LEP-PEA-EPUSP/OpenSourcePowerElectronics-HW-TransformerBoard-2026/Others/20220222_125615.jpg

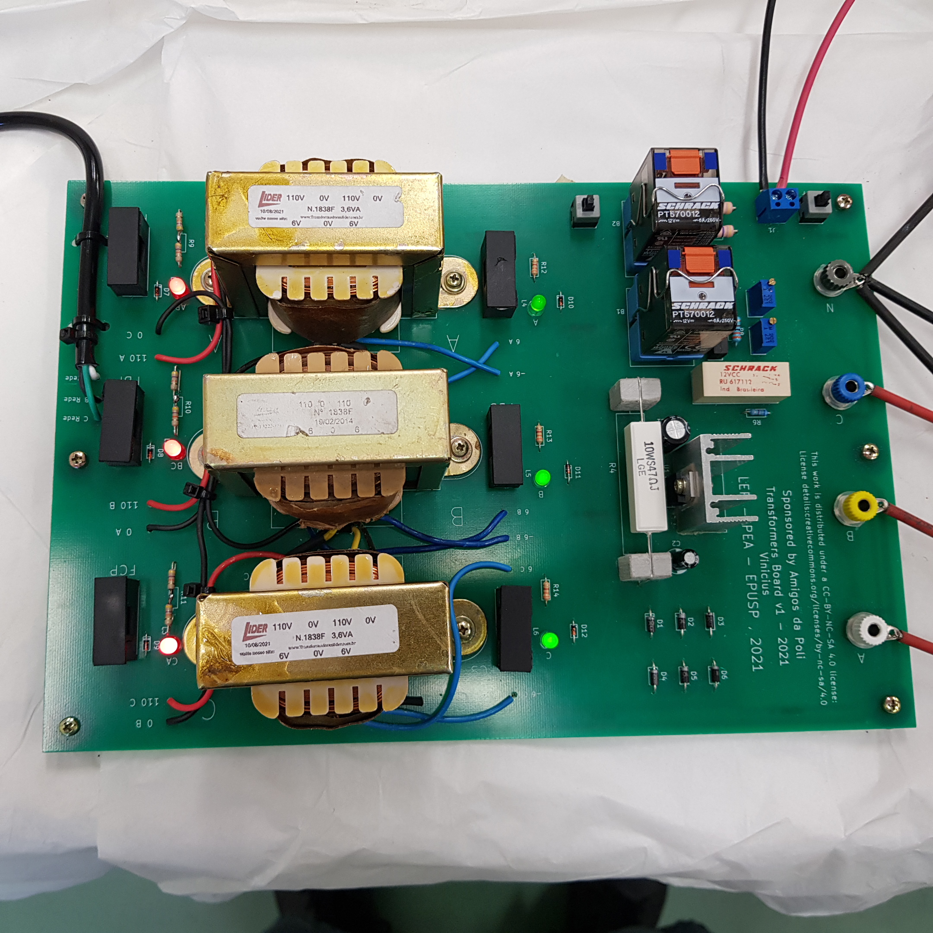
Others/20220222_125615.jpg
