LEP-PEA-EPUSP/OpenSourcePowerElectronics-HW-TransformerBoard-2026/README.md

# OpenSourcePowerElectronics-HW-TransformerBoard-2026

This repository contains the manuals, schematics and layout needed to build and test the transformer board.
