LEP-PEA-EPUSP/OpenSourcePowerElectronics-HW-TransformerBoard-2026/Schematics and Layout/PT570012.PNG

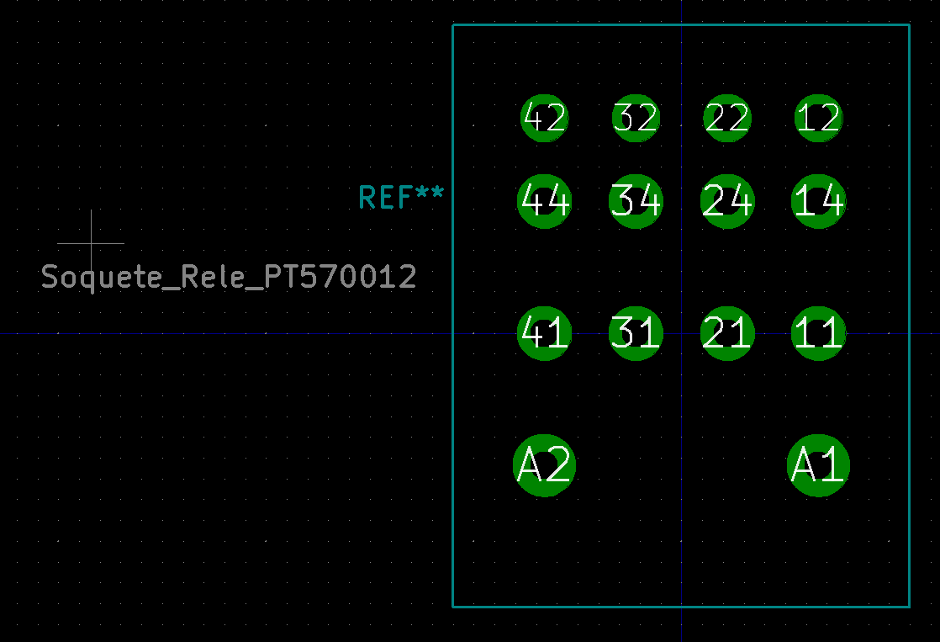
Schematics and Layout/PT570012.PNG
