LEP-PEA-EPUSP/OpenSourcePowerElectronics-HW-TransformerBoard-2026/Schematics and Layout/RU617112.PNG

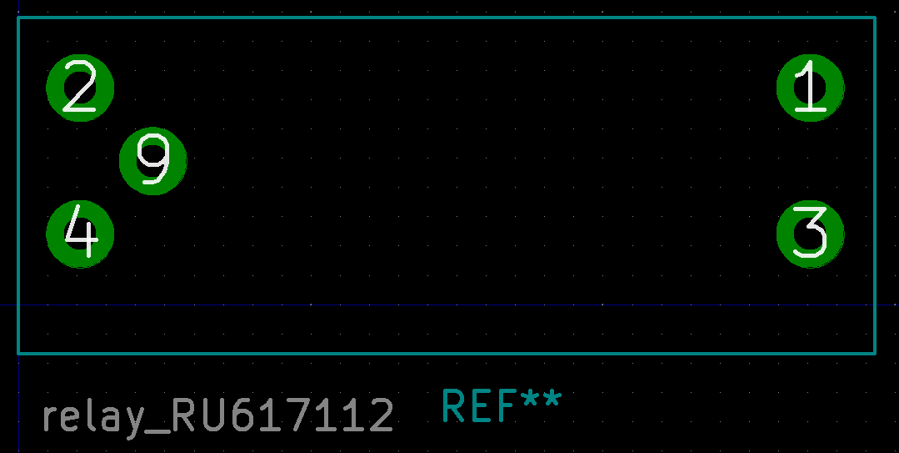
Schematics and Layout/RU617112.PNG
