LEP-PEA-EPUSP/OpenSourcePowerElectronics-HW-TransformerBoard-2026/Schematics and Layout/SH1NAC2.PNG

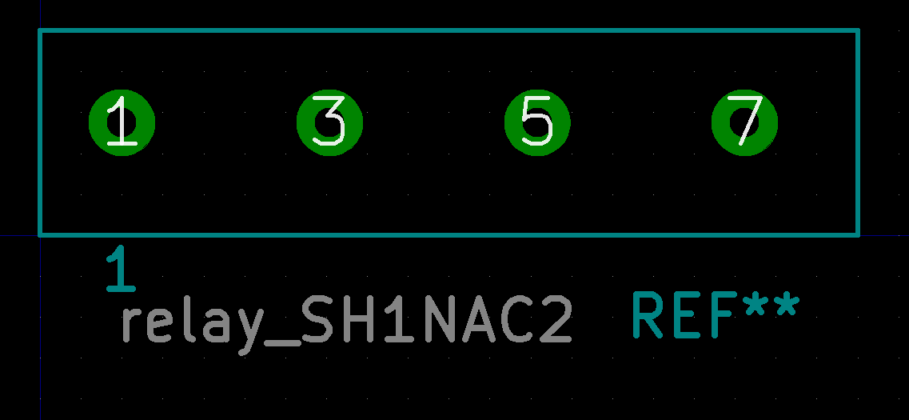
Schematics and Layout/SH1NAC2.PNG
