LEP-PEA-EPUSP/OpenSourcePowerElectronics-HW-TransformerBoard-2026/Schematics and Layout/camadas.pdf

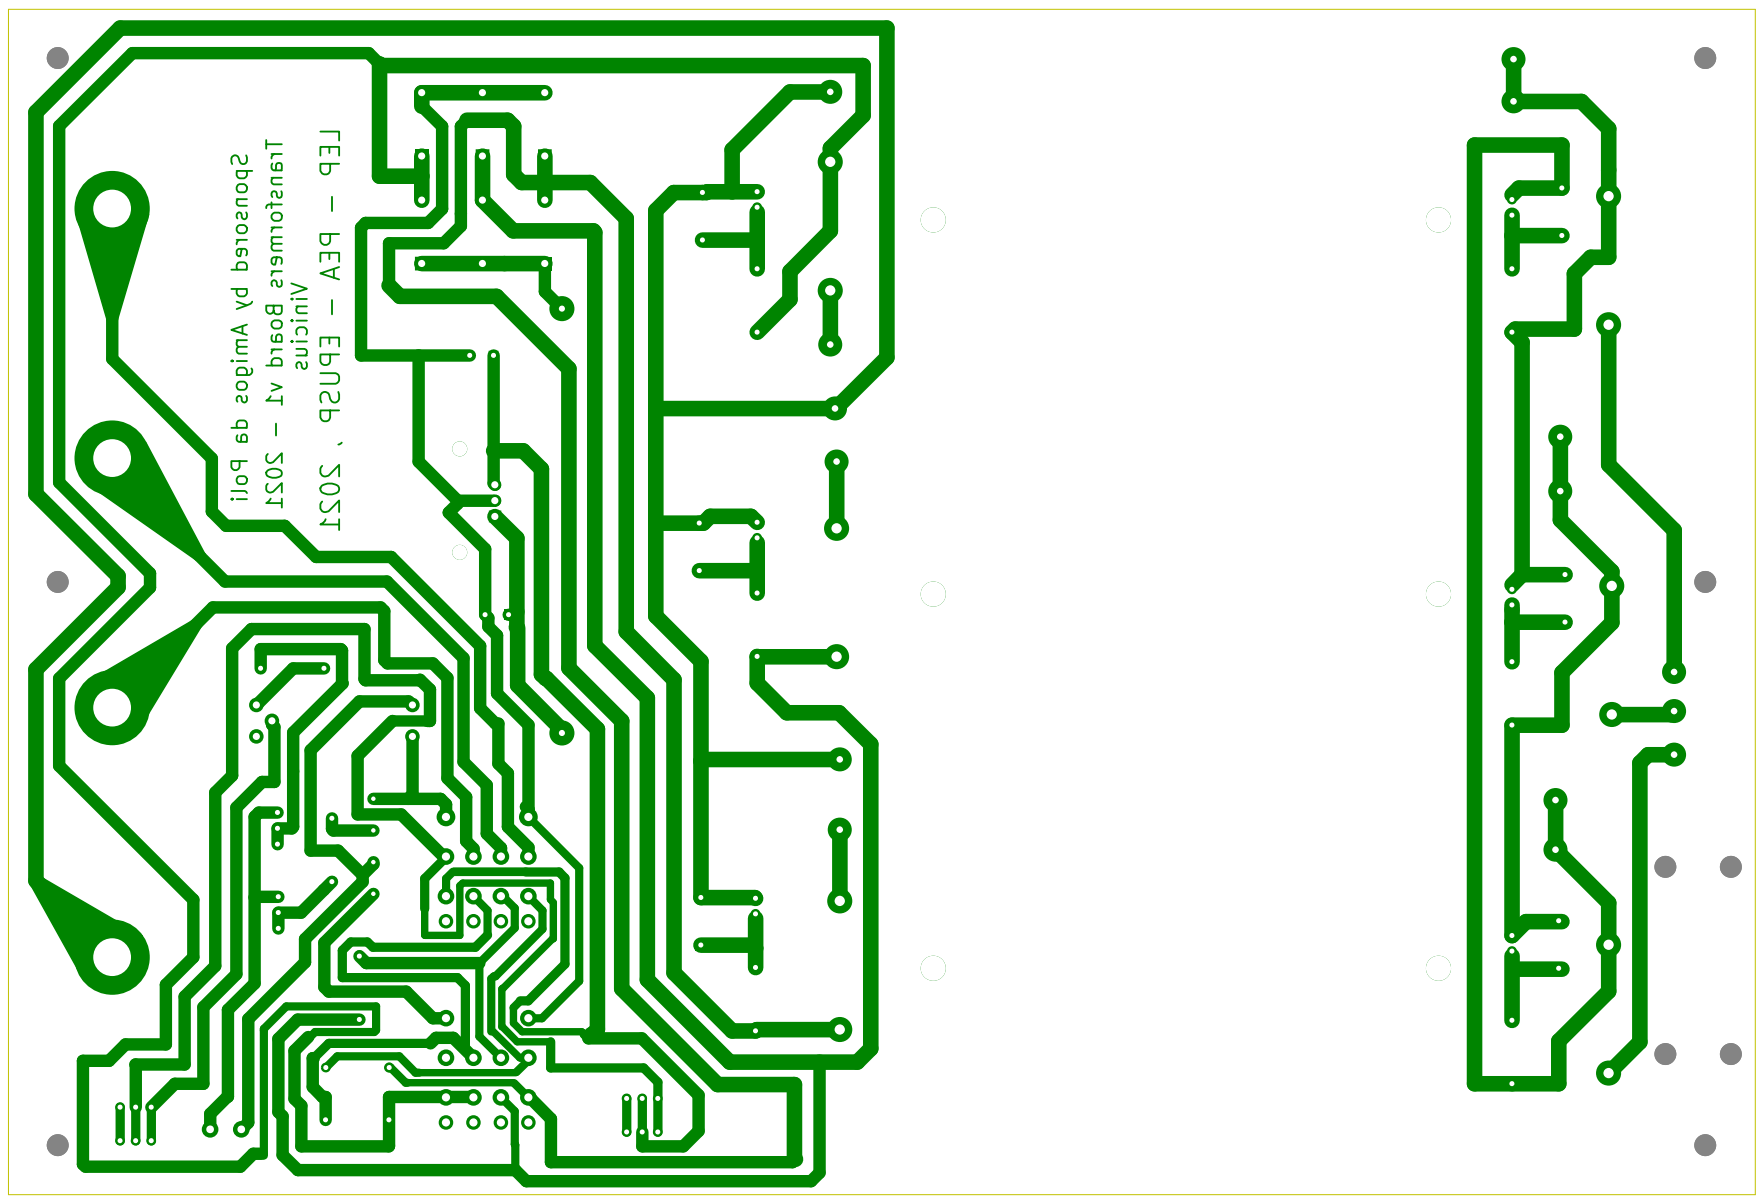
[picture p11: page 1]

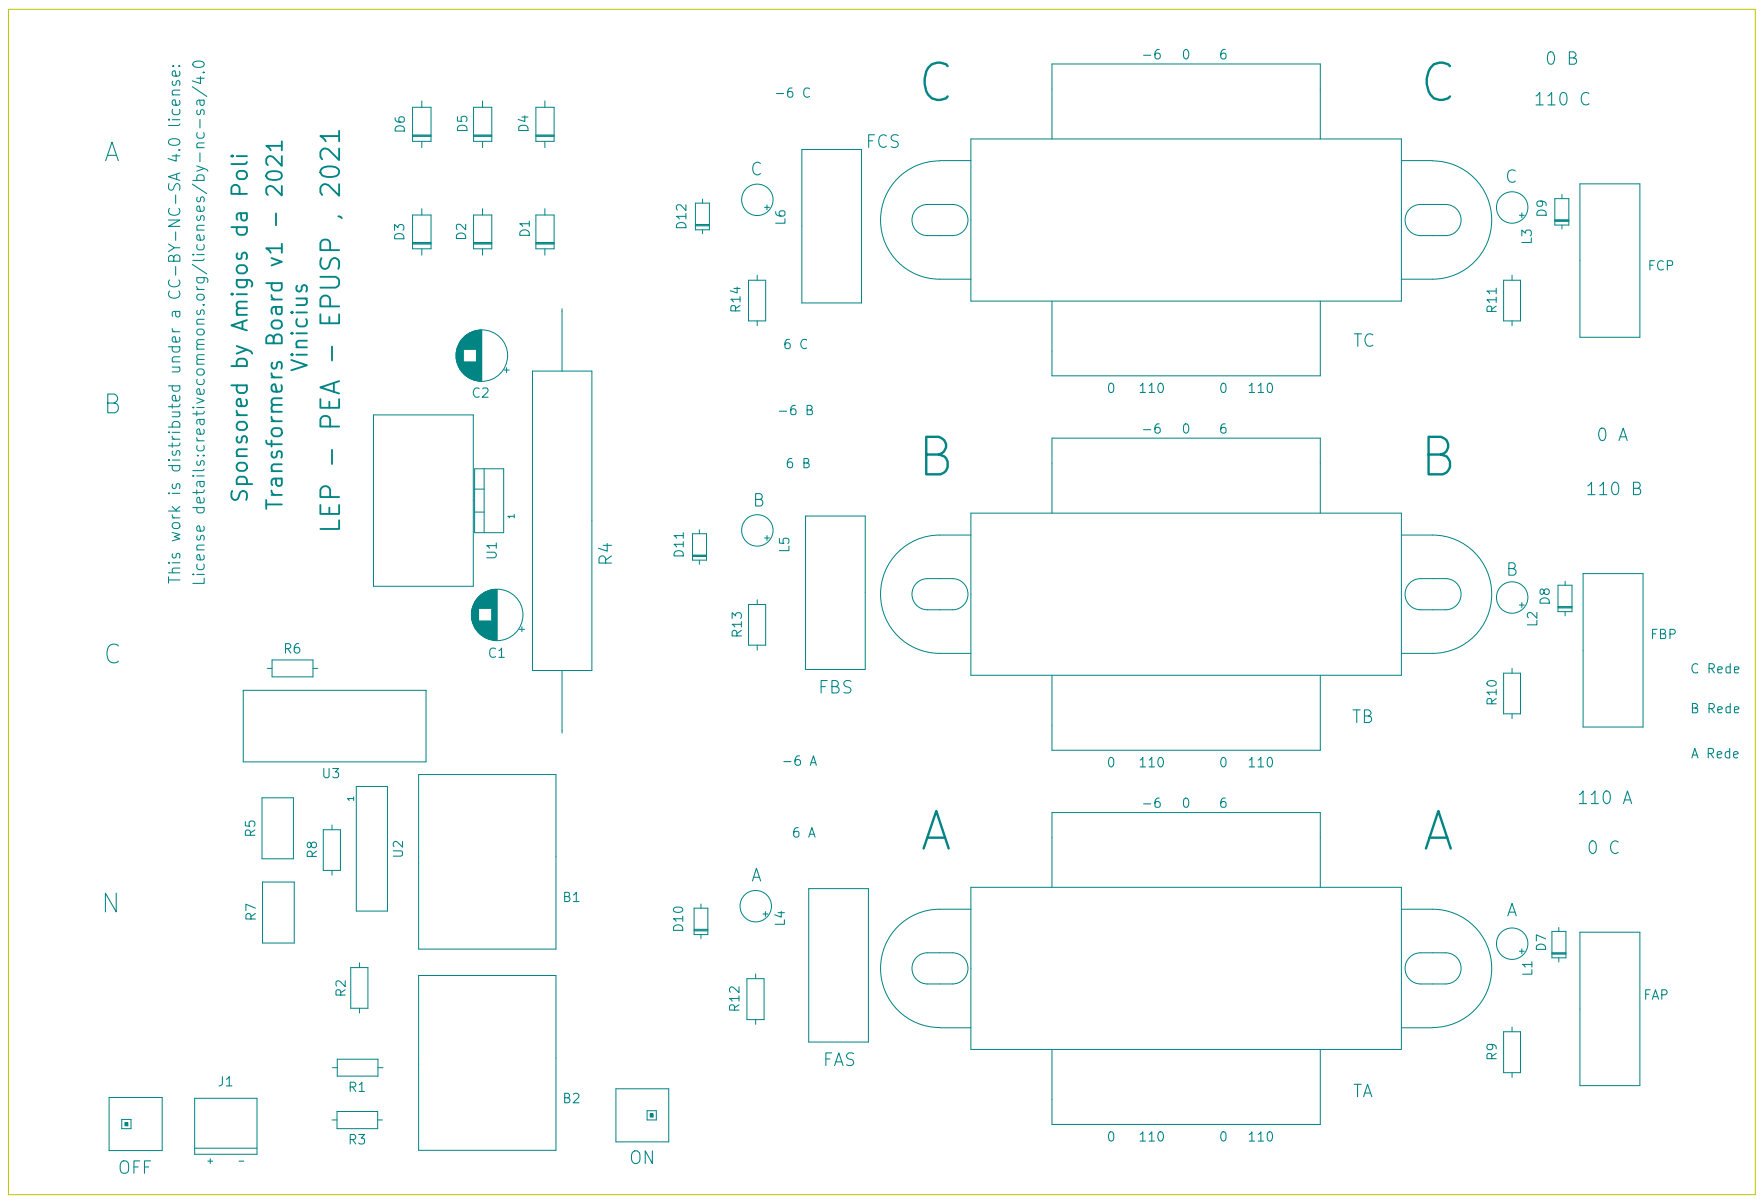
[picture p12: page 2]

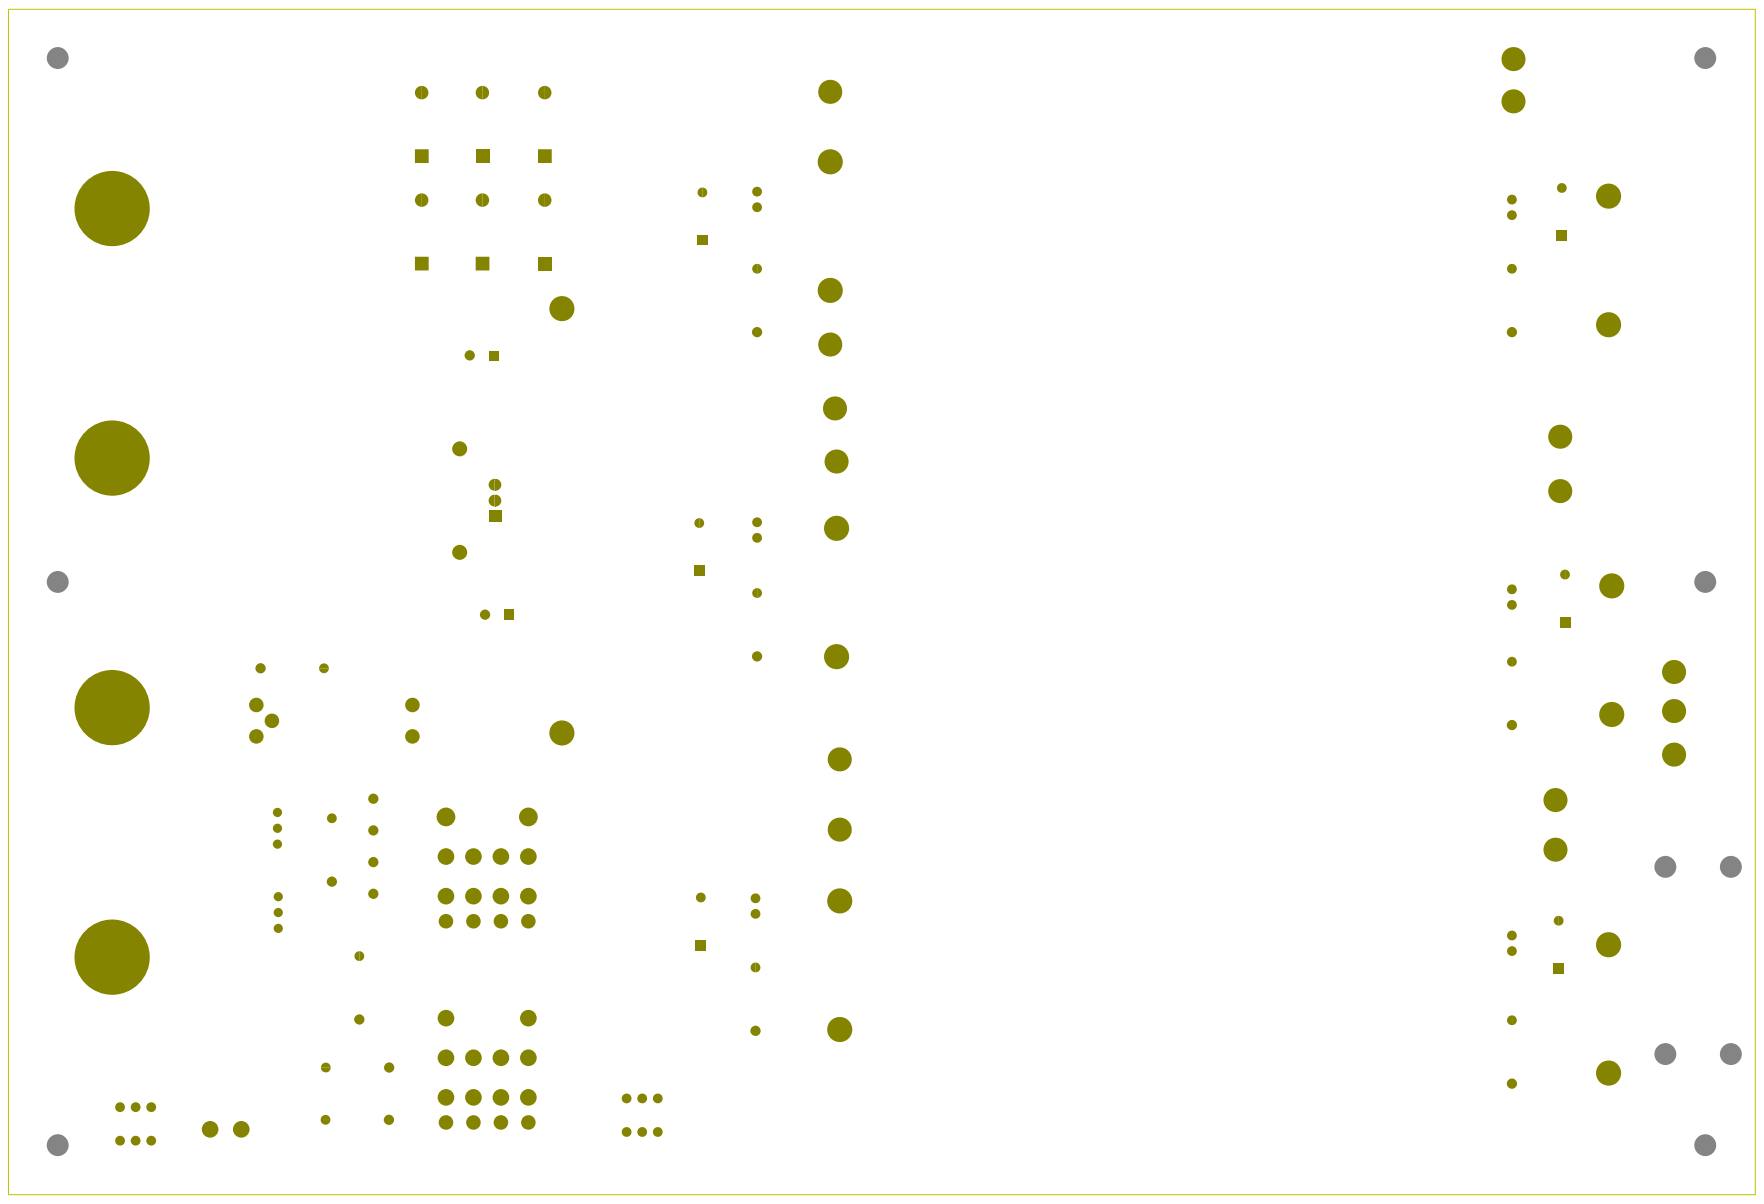
[picture p13: page 3]
