LEP-PEA-EPUSP/OpenSourcePowerElectronics-HW-TransformerBoard-2026/Schematics and Layout/camadas_Trafo.pdf

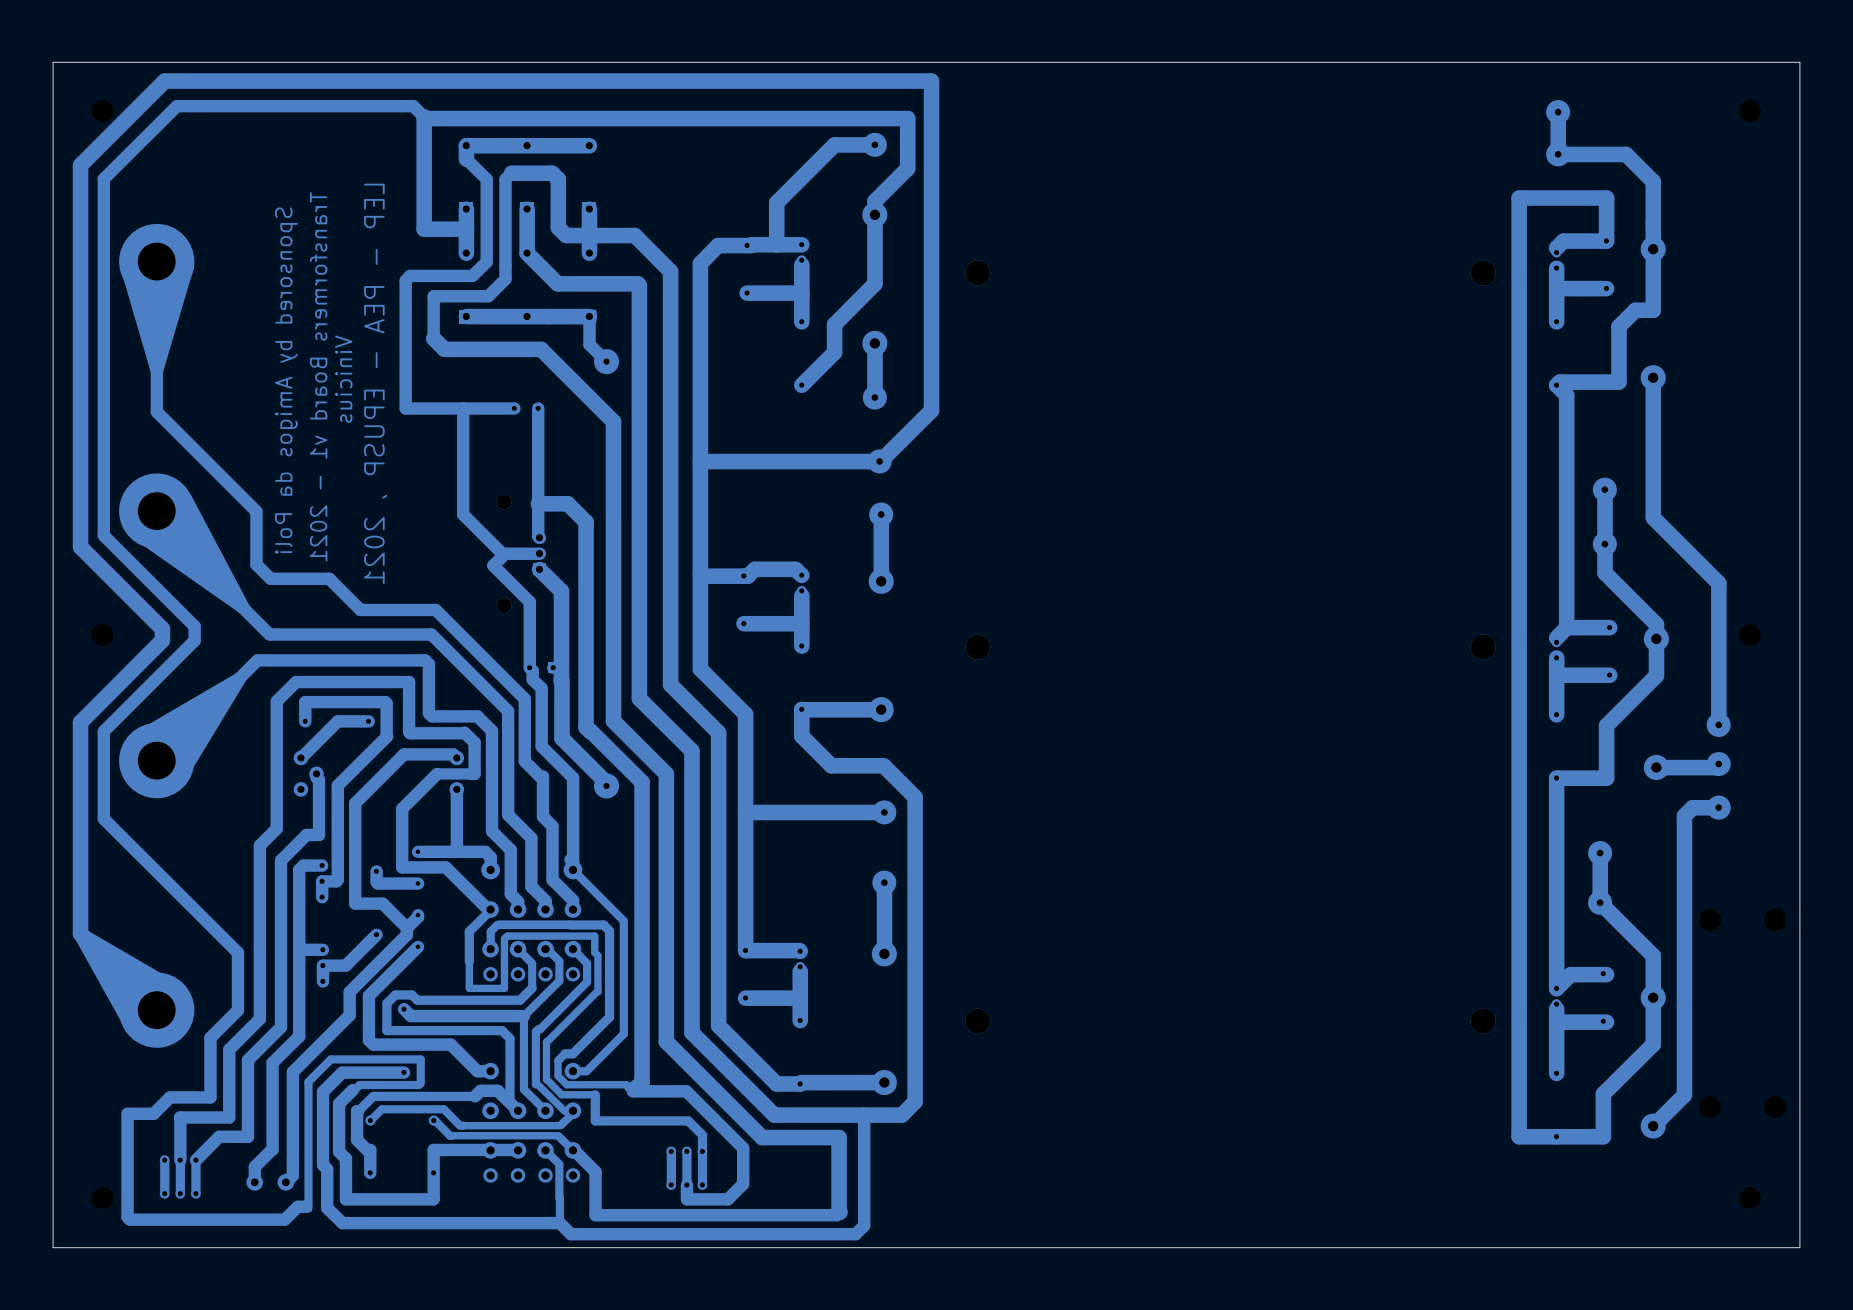
[picture p14: page 1]

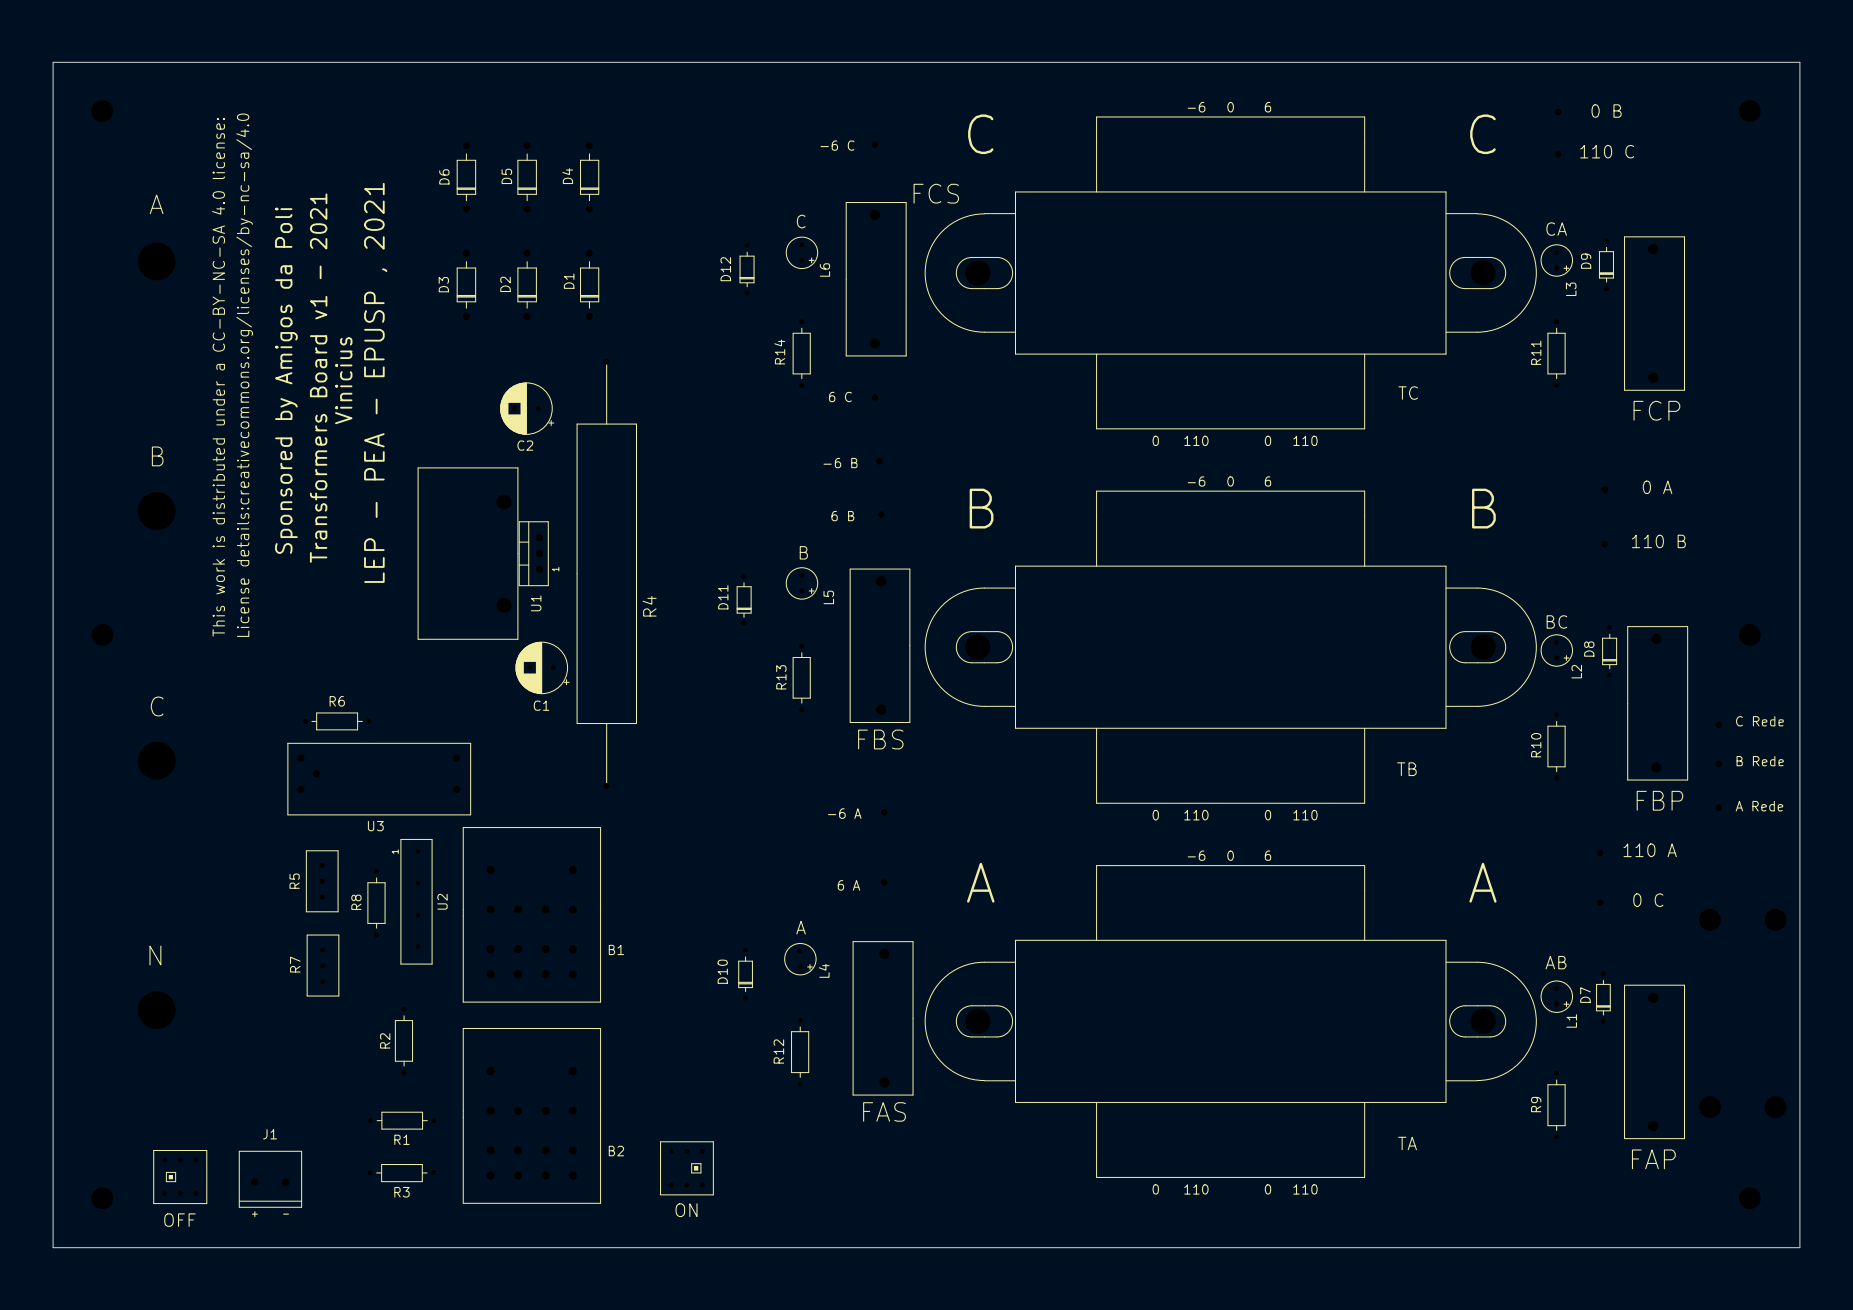
[picture p15: page 2]

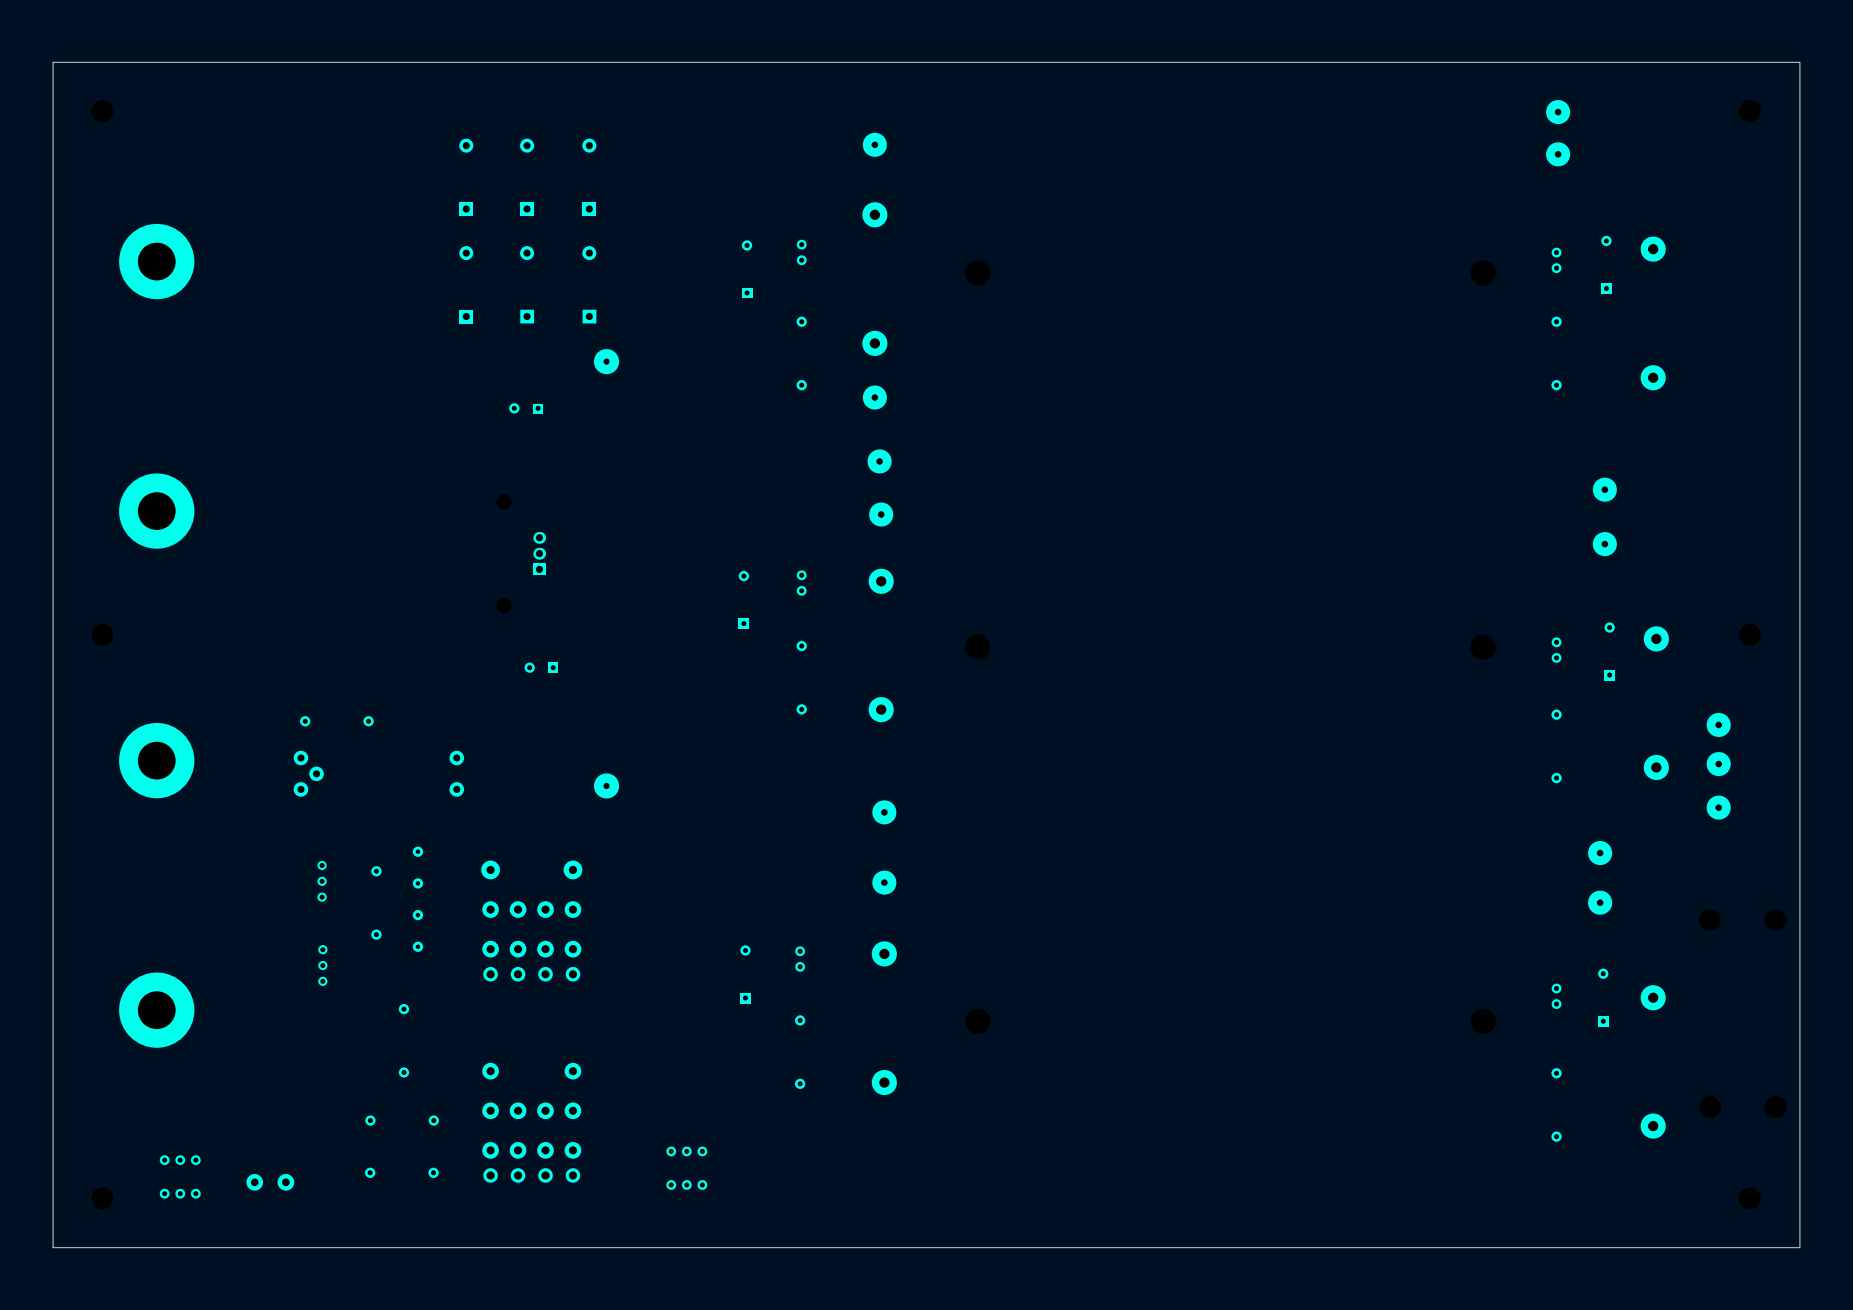
[picture p16: page 3]

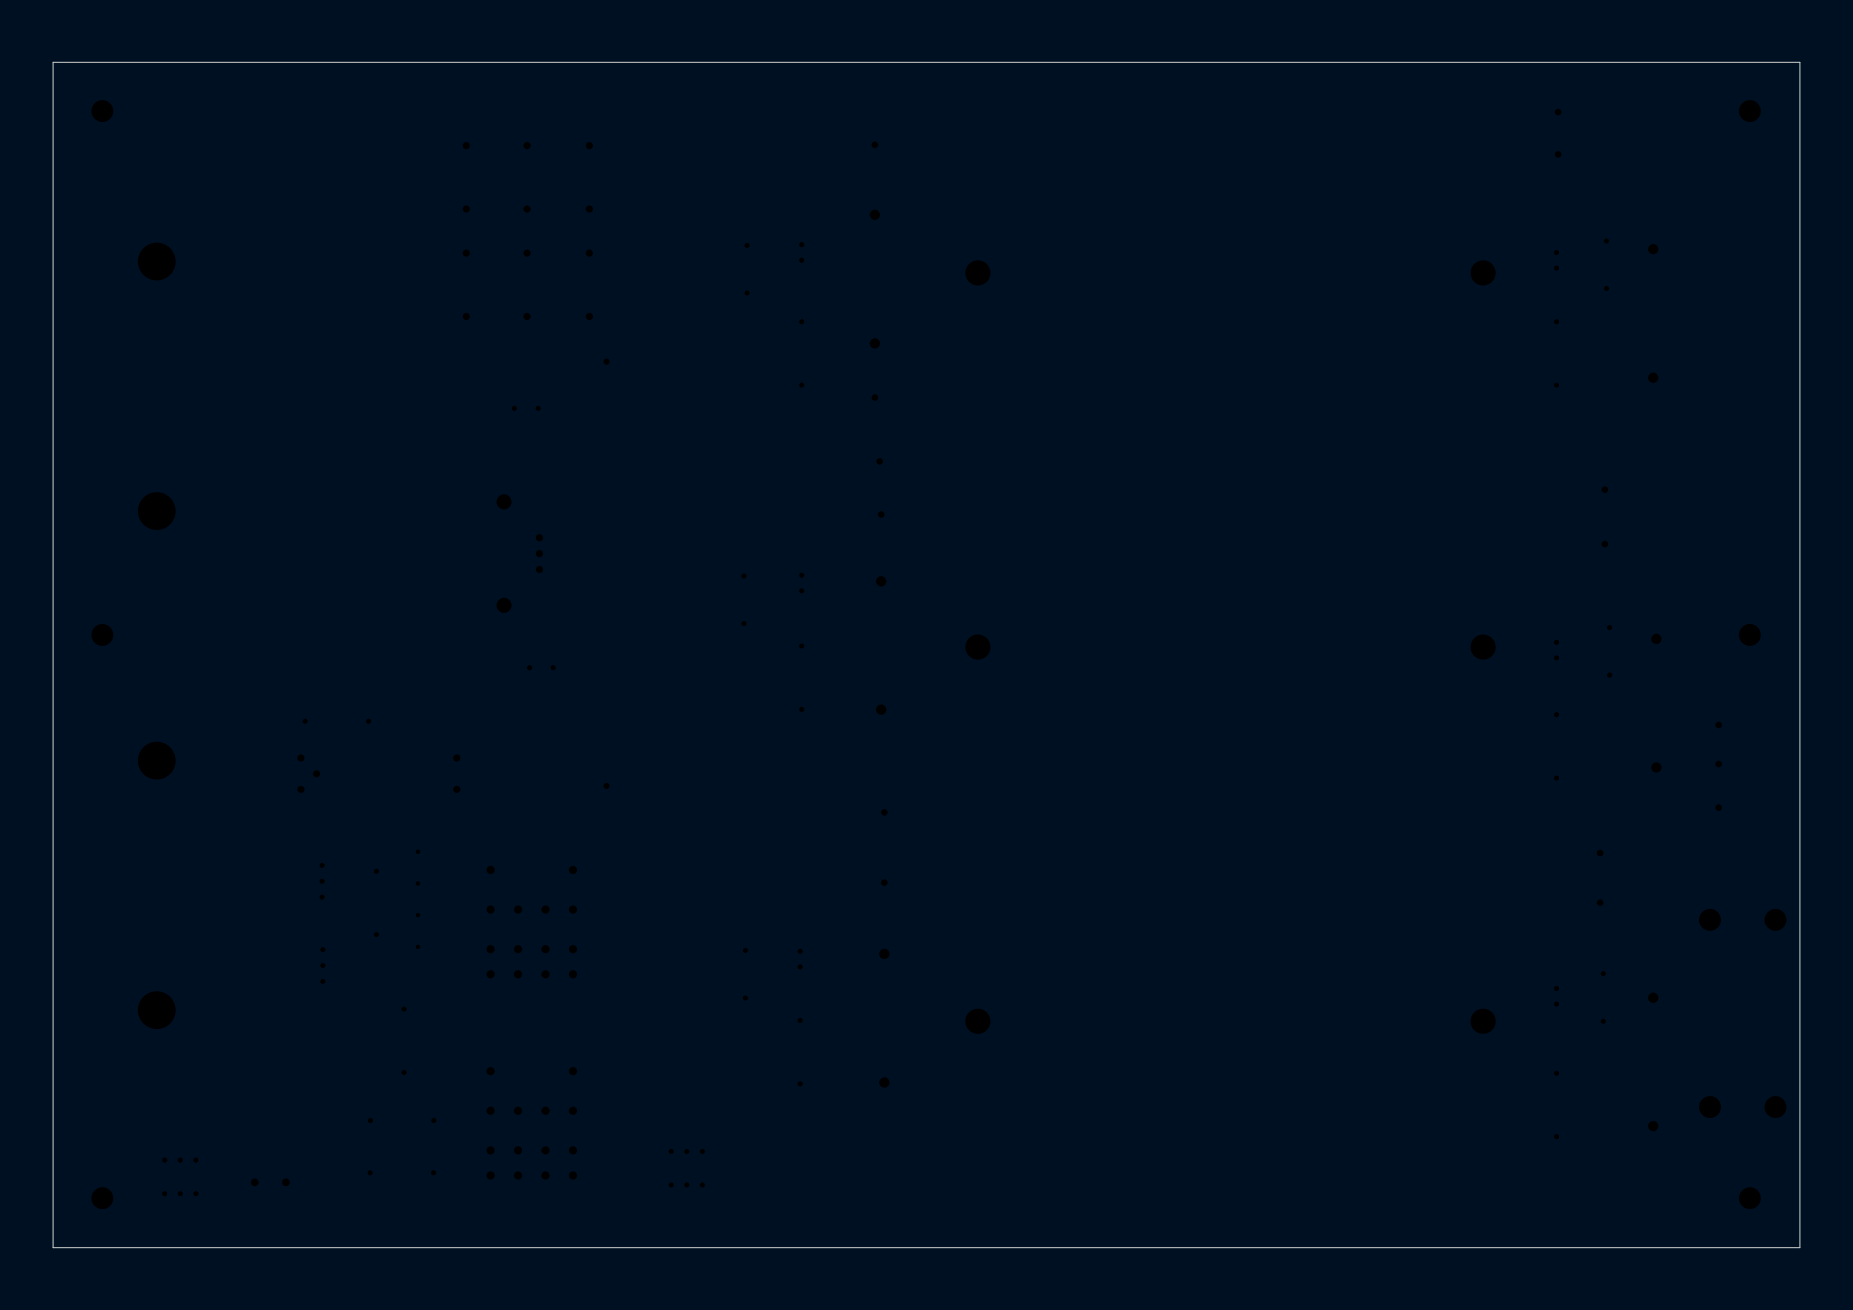
[picture p17: page 4]
