LEP-PEA-EPUSP/OpenSourcePowerElectronics-HW-TransformerBoard-2026/Schematics and Layout/layout_Trafo.pdf

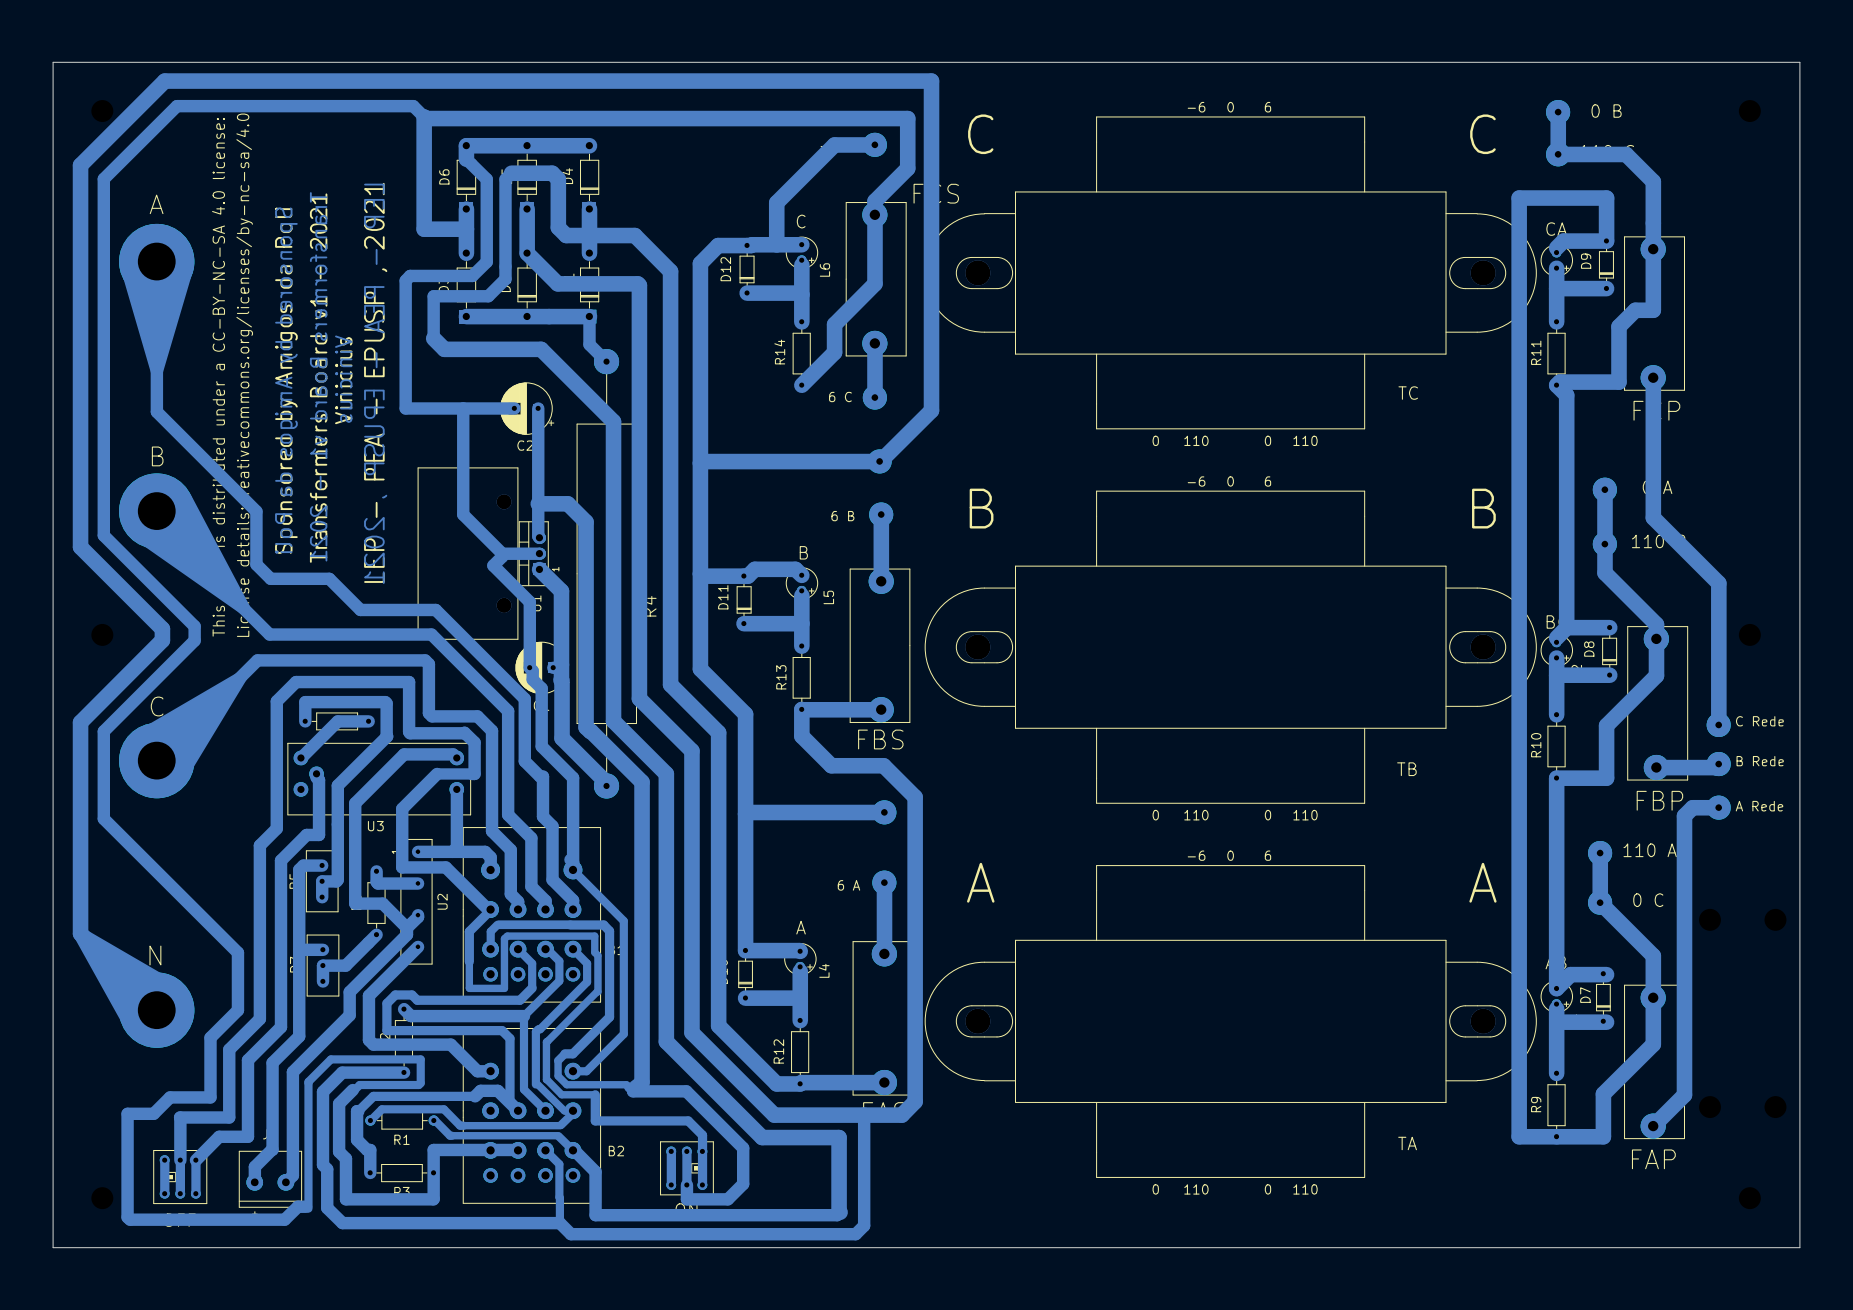
[picture p20: page 1]
