LEP-PEA-EPUSP/OpenSourcePowerElectronics-HW-TransformerBoard-2026/Schematics and Layout/Placa de Trafos.kicad_pcb

## KiCad design Schematics and Layout/Placa de Trafos.kicad_pcb (2026-06-19)

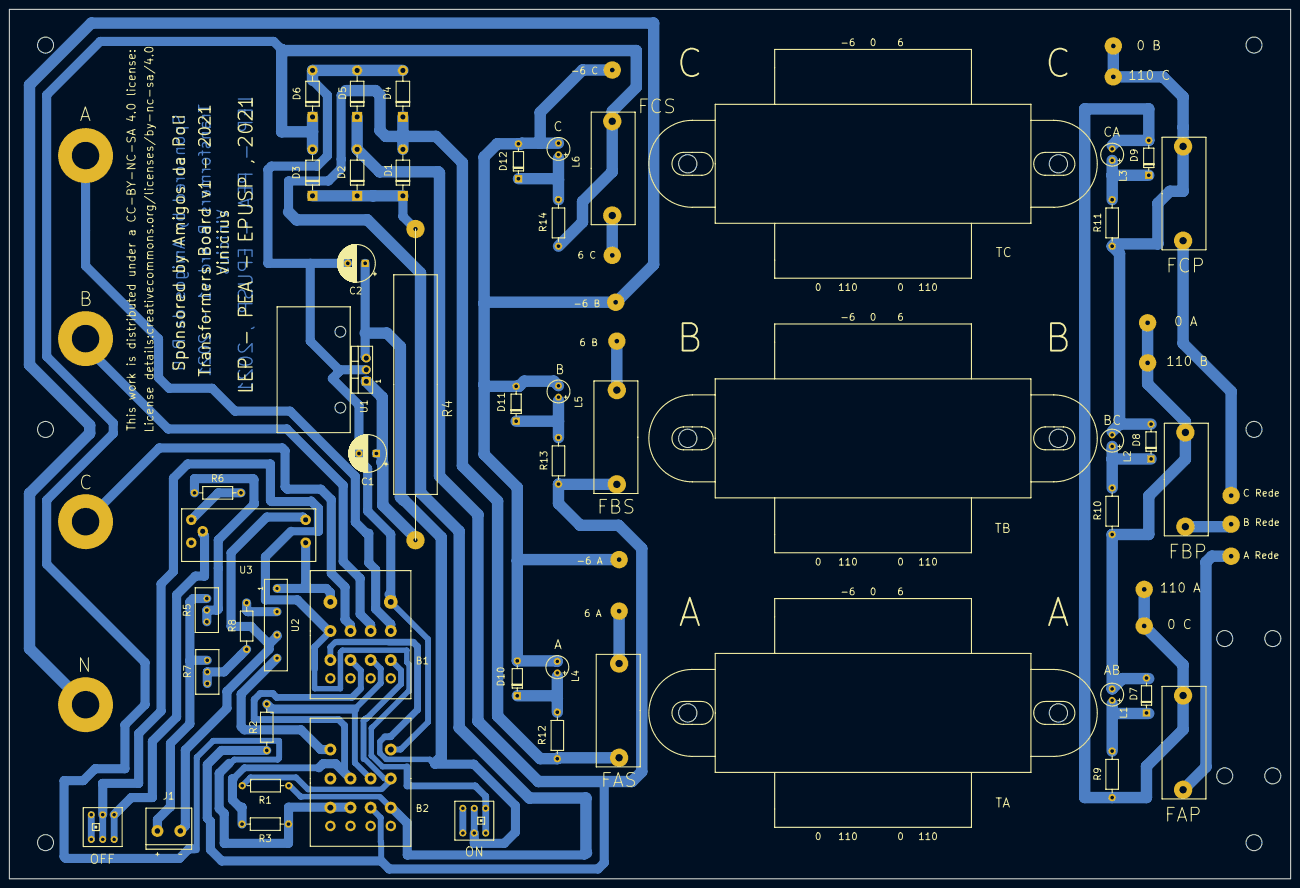
[picture p21: board Placa de Trafos.kicad_pcb from above]

Board: 2 copper layers, 280.0 x 190.0 mm, 80 parts (0 on the bottom side), 39 nets.

Parts:
0_A1, 0_B1, 0_C1, 6_A1, 6_B1, 6_C1, 110_A1, 110_B1, 110_C1: Conn_01x01_Female; cabo_PP
-6_A1, -6_B1, -6_C1: Conn_01x01_Female; cabo_PP
A1: Conn_01x01_Female; Borne
A_rede1: Conn_01x01_Female; cabo_PP
B1, B2: rele_4C; Soquete_Rele_PT570012
B3: Conn_01x01_Female; Borne
B_rede1: Conn_01x01_Female; cabo_PP
C1: 100u/63V; CP_Radial_D8.0mm_P3.80mm
C2: 100u/25V; CP_Radial_D8.0mm_P3.80mm
C3: Conn_01x01_Female; Borne
C_rede1: Conn_01x01_Female; cabo_PP
D1, D2, D3, D4, D5, D6: 1N4001; D_DO-41_SOD81_P10.16mm_Horizontal
D7, D8, D9, D10, D11, D12: 1N4148; D_DO-35_SOD27_P7.62mm_Horizontal
FAP1: Fuse; Porta_Fuse
FAS1: Fuse; Porta_Fuse
FBP1: Fuse; Porta_Fuse
FBS1: Fuse; Porta_Fuse
FCP1: Fuse; Porta_Fuse
FCS1: Fuse; Porta_Fuse
Furo1, Furo2, Furo3, Furo4, Furo5, Furo6, Furo7, Furo8, Furo9, Furo10: Conn_01x01_Female; Furo-pé
J1: Conn_01x02_Female; Conector_parafuso
L1, L2, L3, L4, L5, L6: LED; LED_placa
N1: Conn_01x01_Female; Borne
OFF1: SW_Push_Open; Botao_OFF
ON1: SW_Push; Botao_ON
R1: 33ohms/2w; R_Axial_DIN0207_L6.3mm_D2.5mm_P10.16mm_Horizontal
R2, R3: R; R_Axial_DIN0207_L6.3mm_D2.5mm_P10.16mm_Horizontal
R4: 47ohms/10w; Resistor_10W_porcelana
R5, R7: 2k trimpot; Potentiometer_Bourns_3296W_Vertical
R6: 7k5/1W; R_Axial_DIN0207_L6.3mm_D2.5mm_P10.16mm_Horizontal
R8: 3k3/1W; R_Axial_DIN0207_L6.3mm_D2.5mm_P10.16mm_Horizontal
R9, R10, R11: 100k/2w; R_Axial_DIN0207_L6.3mm_D2.5mm_P10.16mm_Horizontal
R12, R13, R14: 3k3-1/4w; R_Axial_DIN0207_L6.3mm_D2.5mm_P10.16mm_Horizontal
TA1: Transformer_SP_2S; Trafo
TB1: Transformer_SP_2S; Trafo
TC1: Transformer_SP_2S; Trafo
U1: LM7812_TO220; Dissipador
U2: rele_PC; relay_SH1NAC2
U3: rele_ST; relay_RU617112

Connections:
unnamed: 0_A1.1, 110_B1.1, D7.2, FBP1.2, L1.1, R10.1
unnamed: 0_B1.1, 110_C1.1, D8.2, FCP1.2, L2.1, R11.1
unnamed: 0_C1.1, 110_A1.1, D9.2, FAP1.2, L3.1, R9.1
unnamed: 6_A1.1, FAS1.1
unnamed: 6_B1.1, FBS1.1
unnamed: 6_C1.1, FCS1.1
unnamed: -6_A1.1, -6_B1.1, -6_C1.1, D10.2, D11.2, D12.2, L4.1, L5.1, L6.1, N1.1
unnamed: A1.1, B1.41
unnamed: A_rede1.1, FAP1.1
unnamed: B1.11, OFF1.2, ON1.1
unnamed: B1.14, C2.1, ON1.2, U1.3
unnamed: B1.21, C3.1
unnamed: B1.24, B2.21, R3.2
unnamed: B1.31, B3.1
unnamed: B1.34, B2.31, R2.2
unnamed: B1.44, B2.41, R1.2
unnamed: B1.A1, U2.1, U3.3
unnamed: B1.A2, B2.A2, C1.2, C2.2, D4.2, D5.2, D6.2, U1.2
unnamed: B2.14, B2.24, D3.2, D6.1, FCS1.2, R3.1, R14.1
unnamed: B2.34, D2.2, D5.1, FBS1.2, R2.1, R13.1
unnamed: B2.44, D1.2, D4.1, FAS1.2, R1.1, R12.1
unnamed: B2.A1, U2.7
unnamed: B_rede1.1, FBP1.1
unnamed: C1.1, R4.2, U1.1
unnamed: C_rede1.1, FCP1.1
unnamed: D1.1, D2.1, D3.1, R4.1
unnamed: D7.1, L1.2, R9.2
unnamed: D8.1, L2.2, R10.2
unnamed: D9.1, L3.2, R11.2
unnamed: D10.1, L4.2, R12.2
unnamed: D11.1, L5.2, R13.2
unnamed: D12.1, L6.2, R14.2
unnamed: J1.1, R5.1, R7.1
unnamed: J1.2, U2.5, U3.1
unnamed: OFF1.1, U3.9
unnamed: R5.2, R5.3, R6.1
unnamed: R6.2, U3.2
unnamed: R7.2, R7.3, R8.1
unnamed: R8.2, U2.3
