LEP-PEA-EPUSP/OpenSourcePowerElectronics-HW-TransformerBoard-2026/(notices)

Notices in the files:
Schematics and Layout/Placa de Trafos.kicad_pcb:
License details:creativecommons.org/licenses/by-nc-sa/4.0
This work is distributed under a CC-BY-NC-SA 4.0 license:
